Tobycsc/2dof-experiment-system/Readme.md

system-MainBoardv2

目前V2版本PCB使用的程序，芯片为STM32F407VET6，主要Task分别在对应.c文件内编写

gimbal.task为主任务，通信协议.docx中对其中变量定义与串口协议有详细说明，请不要参考论文最后的附录

论文描写内容绝大部分符合软件开发逻辑，有变化的部分主要为串口任务，目前串口处理逻辑为直接在uart_task内直接对gimbal_ctrl内变量进行更改，并调用写入flash，pid初始化等函数

### 目前问题

#### 电源拓补问题

电池单独供电时电机启动抽载过大导致母线电压降低，MCU因电压过低重启

1.线损过大 需重新设计接口或直接焊线（pcb线损待测）

2.母线并大电容

3.重做供电拓补 更换电源管理芯片 更换母线电压

4.更换电池类型，如动力锂电池/高能锂电池

#### 控制效果问题

单环PID控制效果不好

已写好双环PID所需框架，需后续调参
