Tobycsc/2dof-experiment-system/南京航空航天大学毕业设计（论文）.pdf

编号 182110424

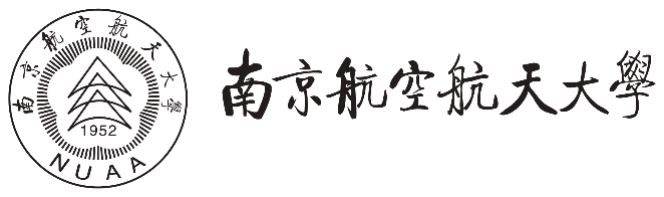
[picture p1: figure]

# 本科毕业设计（论文）

题 目

# 二自由度飞行姿态试验平台设计与

控制

学生姓名 | 于文俊
学 | 号 | 182110424
学 | 院 | 能源与动力学院
专 | 业 | 飞行器动力工程
班 | 级 | 0221104
指导教师 | 黄向华教授

### 二〇二五年六月

### 南京航空航天大学

### 本科毕业设计（论文）诚信承诺书

本人郑重声明：所呈交的毕业设计（论文）是本人在导师的指导下独立进行研究所取

得的成果。论文核心内容（如研究设计、数据分析、结论等）均为原创，未使用 AI 进行数

据篡改与虚构、规避查重等违规操作。尽我所知，除了文中特别加以标注和致谢的内容外，

本设计（论文）不包含任何其他个人或集体已经发表或撰写的成果作品。对本设计（论文）

所涉及的研究工作作出贡献的其他个人和集体，均已在文中以明确方式标明。

作者签名：

日 期： 2025 年 5 月 25 日

### 南京航空航天大学

### 毕业设计（论文）使用授权声明

本人完全了解南京航空航天大学有关收集、保留和使用本人所送交的毕业设计（论文）

的规定，即：本科生在校攻读学位期间毕业设计（论文）工作的知识产权单位属南京航空

航天大学。学校有权保留并向国家有关部门或机构送交毕业设计（论文）的复印件和电子

版，允许论文被查阅和借阅，可以公布论文的全部或部分内容，可以采用影印、缩印或扫

描等复制手段保存、汇编论文。保密的论文在解密后适用本声明。

论文涉密情况：

不保密 保密

保密期（起讫日期： 至 ）

作者签名： | 导师签名：
日 | 期： 2025 年 5 月 25 日 | 日 | 期： 2025 年 5 月 28 日

摘 要

二自由度飞行姿态实验平台作为《自动控制原理》等课程的实践载体，其教学价值日

益凸显，通过实体平台的操作，学生能够直观理解系统建模、控制器设计、稳定性分析等

关键知识点，并验证 PID 算法、频域响应等理论的实际效果。

目前各高校在本科教育流程中，缺少可靠有效的二自由度飞行姿态实验平台开展实践

教学。南京航空航天大学的李明洲、黄向华、张天宏于 2021 年申请了一种轻便的二自由度

飞行姿态控制实验台专利，在实践过程中发现一些问题导致该设计不能被广泛应用。本文

在其专利基础上进行修改与再设计，在实现功能的基础上增加其稳定性、安全性与可量产

性。

本设计中，结构上参考原专利的二自由度设计，同时调整 roll 轴轴线位置以更好的模

拟多旋翼飞行器的飞行状态。PCB 设计上保留原试验台的集成设计，使整个装置更为轻巧

便携。软件上部署 FreeRTOS 操作系统，保证姿态解算，控制与转发的实时性，最大程度

上提高控制效果。使用外部控制与自主控制两种模式，满足多种场景的需求。自主控制模

式中使用 PID 控制器进行姿态控制，通过简单的调参可实现最基础的姿态稳定。

通过多次迭代，已经实现预定的基础功能，自主控制效果较为理想，且外部控制功能

正常。

关键词：飞行姿态实验平台，专利产品化，PCB 设计，嵌入式开发，PID 控制器，上位

机通信

i

ABSTRACT

The two-degree-of-freedom (2-DOF) flight attitude experimental platform, as a practical

teaching tool for courses such as Automatic Control Principles, has demonstrated increasing

educational value. Through hands-on operation of the physical platform, students can intuitively

grasp key concepts including system modeling, controller design, and stability analysis, while

validating the practical effectiveness of theories like PID algorithms and frequency-domain

responses.

Currently, universities lack reliable and efficient 2-DOF flight attitude experimental platforms

for practical education. Li Mingzhou, Huang Xianghua, and Zhang Tianhong from Nanjing

University of Aeronautics and Astronautics patented a lightweight 2-DOF flight attitude control

experimental platform in 2021. However, issues identified during implementation hindered its

widespread adoption. This study modifies and redesigns their patented solution, enhancing

stability, safety, and mass producibility while retaining core functionalities.

Structurally, the design adopts the original 2-DOF framework but adjusts the roll axis position

to better simulate the flight dynamics of multi-rotor aircraft. For PCB design, the integrated layout

of the original platform is preserved to ensure compactness and portability. Software-wise,

FreeRTOS is deployed to guarantee real-time performance in attitude calculation, control, and data

transmission, optimizing control efficacy. The platform supports both external and autonomous

control modes to accommodate diverse scenarios. In autonomous mode, a PID controller is

implemented for attitude stabilization, enabling basic stability through straightforward parameter

tuning.

After iterative refinements, the platform achieves its foundational objectives: autonomous

control delivers satisfactory performance, and external control functions operate reliably.

KEY WORDS: Flight attitude experimental platform, Patent commercialization, PCB design,

PID controller, Host computer communication

ii

目录

iii

南京航空航天大学本科毕业设计（论文）

### 第一章 绪论

1.1 背景和意义

1.1.1 自动控制实验教学设备

由被控制系统与可自定义参数的控制器组成的教学实验系统是自动控制原理教学与

飞行器控制研究的重要载体。通过实体平台的操作，学生可直观验证 PID 控制、状态反馈、

频域分析等核心理论，并实践参数整定、系统建模等技能。例如，通过调节 PID 参数观察

姿态响应，能够深化对伯德图、奈奎斯特稳定性判据的理解。

1.1.2 低空经济与其载体

随着无人机、垂直起降飞行器等技术的快速发展，对飞行控制系统的教学与科研需求

日益增长。近期国家正快速发展低空经济，以满足秩序维护、设施巡检、农业工作等多项

任务需求，而低空经济的基础即为多旋翼无人飞行器。通过惯性传感器，光流传感器与激

光测距传感器等多种数据的输入与融合，飞控算法可以计算出各动力电机的期望输出，使

飞行器在空间中的六个自由度稳定可控。多旋翼无人飞行器的控制为典型的多输入多输出

系统控制。

1.1.3 二自由度飞行姿态实验平台

通过资料查询与实地调查，发现传统教学实验设备通常难以满足此类系统的控制模拟

需求。目前教学常用的电气实验箱可以模拟多种控制场景，但仅有电压模拟量输出，不够

直观；而电机等实验设备仅支持单变量控制，难以体现多自由度耦合、非线性动力学等复

杂控制场景，导致学生难以深入理解多输入多输出系统特性。同时，传统教学实验设备大

多依赖校内实验室环境，需要多种设备协同工作，不方便带到课堂等其他环境进行演示或

进行自定义算法验证。

针对以上痛点，一种二自由度飞行姿态实验平台的概念被提出。通过简单的轴系组成

拥有俯仰与滚转两个自由度的系统，同时固定两个驱动螺旋桨的电机在集成了惯性姿态传

感器的 PCB 上，可实现对两个自由度的闭环控制。将姿态解算与控制算法部署在 PCB 上

的 MCU 内，能够通过独立的实验装置完成所有控制任务，并提供对外接口完成自定义的

其他功能，为航空航天领域培养具备复杂系统设计能力的人才提供支持。

第一章 绪论
1.2 国内外研究现状

国内高校及科研机构在飞行姿态实验平台的设计与应用方面，主要基于实验平台来验

证新型的控制算法，重点放在实验平台的动力学系统建模与实际控制效果验证，而非面向

本科生的实验教学。

哈尔滨工业大学汤文开发的高精度飞行模拟器基于欧拉-拉格朗日方程建立非线性动

力学模型，系统复杂度高；清华大学尹航等开发了一款可变负载的非线性飞行姿态模拟系

统。但上述两种系统都是模拟传统构型直升机的动力学特性，即主旋翼＋尾旋翼的设计，

与多旋翼飞行器的动力学特性和控制方法相差甚远。

中国民航大学孟忱等开发的飞机电传操纵及模拟加载系统实验台则基于真实飞机电

传控制系统开发，可以很好的还原电传飞机舵面的控制特性，并应用在实验教学中。但此

系统为还原真实飞机电传系统，作动器与传感器等体积较大，且要结合专用实验箱进行操

作，不便于在其他位置使用。

国外相关领域则有部分商业公司与高校团队进行产品开发，但相关产品基本针对大型

实验室，且售价较高。同样，此类产品大多被用于先进的控制算法验证，而非协助自动控

制原理的入门。

Feedback 公司、加拿大 Quanser 公司、捷克 Humusoft 公司都有生产此类仿真实验平台

且均为两个自由度的仿真模型，分别由两个电机来驱动两个螺旋桨，根据俯仰和航向这两

个常用方向设计模型。与国内开发的类似模型相同，同样不符合多旋翼飞行器的模拟需求。

高校已经把成熟的控制方法的应用在这些商品上，取得了良好研究成果。斯坦福大学

将模型预测控制（MPC）应用于教学平台，验证先进控制理论的实际效果；苏黎世联邦理

工学院（ETH Zurich）则基于强化学习实现自适应控制。慕尼黑工业大学的 FlyCrane 平台

采用四自由度设计，集成高度控制维度，配套 30 余个实验案例库，支持鲁棒控制与自适应

控制研究，但单套成本较高。

1.3 本文主要工作

与工业级试验平台或实验室专用的算法验证平台不同，面向本科教育的实验系统需兼

顾理论验证、操作安全性、成本可控性和教学直观性。同时为便于大规模铺开与应用，系

统需要有一定的可靠性、安全性与量产性。

本文针对当下研究情况与原专利存在的痛点，设计了一款高度集成化的二自由度飞行

姿态试验系统，并实际制作了样品验证了其有效性。

1.3.1 原专利存在的问题

原设计中使用外置试验箱完成传感器数据采集、控制算法执行、电动机驱动三项任务，

其与试验台主体间的连接需同时传输模拟信号与功率驱动电流，干扰较大。二自由度试验

平台对实时性与准确性要求较高，外置试验箱的控制效果并不理想。同时模拟信号需要专

用设备进行解算，不便于自定义开发相关控制算法，且不够便携。

原设计的 Roll 轴并未穿过前部结构重心，在 Roll 轴不为零时结构自身的重量会产生

一个回正力矩，导致整个系统的动力学特性与多旋翼飞行器不一致。

1.3.2 新设计主要创新点

实验装置主体部分布置了六轴惯性测量单元与微处理器，只需供电即可实现自身的姿

态解算。同时电机与驱动电路也集成在此部分，使用微处理器进行电机转速控制。将上述

模块全部布置在一块 PCB 上并安装在主体部分，同时设置数字通信接口，即可通过上位机

通信来满足自定义控制需求。

针对结构方面的问题，修改 Roll 轴位置，同时在 PCB 的安装位置使用槽孔，即可调

整主体部分重心，使其穿过 Roll 轴，能够更好地模拟多旋翼飞行器的动力学特性。

为满足便携需求，将系统供电部分也集成在内，配合锂电池与充电管理电路，可以实

现系统完全脱离其他设备独立运行。将 USB 充电与上位机通信集成在 TypeC 接口上进一

步提高系统集成度。

1.4 论文组织结构

本论文的组织结构如下：

第一章 阐明课题的研究背景，介绍课题的研究现状和来源，并概述论文的主要工作和

创新点。

第二章 阐述设计的整体思路，展示系统框图；

第三章 介绍设计的结构部分与硬件原理图、PCB 设计；

第四章 介绍设计的嵌入式软件部分与控制算法，展示 PID 控制器效果；

第五章 总结全文，对今后的研究做出总结和展望。

第二章 系统整体设计概览

### 第二章 系统整体设计概览

2.1 系统设计思路

二自由度飞行姿态试验平台的开发涉及多个技术栈，包括结构设计，电路设计，PCB

设计与嵌入式软件开发。本节将会针对系统的需求进行分析，并将其分解以逐个实现。

2.1.1 需求分析

（1） 特性仿真

作为模拟多旋翼飞行器控制的实验平台，需要尽可能的模拟其动力学特征，包括被控

制系统与作动器输出特性，以保证控制算法的正常执行。

（2） 控制性能

飞行器控制对实时性与准确性要求高，无论是哪种控制方法都需要传感器与执行机构

的性能满足要求。

（3） 交互性

作为实验教学设备，需要满足教学需求，包括但不限于能够实时调整参数并展示控制

效果，有控制量与被控制量的直观显示等功能。

（4） 安全性与可靠性

由于系统存在高速运转的部件，且其运行状态能够自定义，需考虑设置权限高的安全

保护逻辑防止系统本身或操作者受到伤害。同时自身也要保证能够在尽可能宽广的环境内

稳定运行。考虑到本科生实验环境的多种恶劣条件与不当操作，需要采取措施最大限度保

证系统与操作者的安全。

（5） 量产性与通用性

为保证能够大规模铺开使用，需考虑可生产性与成本因素，包括生产工艺，器件选型

等方面。同时尽可能满足多种实验需求，做到一套装置通过可调部分完成各项不同的功能。

2.1.2 需求分解与实现

（1） 结构

参考原设计的轴系实现俯仰与滚转两个自由度的运动，同时修改轴系位置以模拟真实

飞行器的动力学特性。滚转轴放在俯仰轴上的设计可以使俯仰轴的控制模拟飞行器的高度

控制逻辑，并与滚转轴耦合，相当于减少了自由度的多旋翼飞行器。

结构材料使用 3D 打印件，降低研发成本，同时以板材设计逻辑进行建模，若有量产

需求可转为板材以大批量生产。提前考虑装配工艺设计，保证量产性。

将 PCB 板作为主体结构的一部分，同时各安装孔位使用阵列孔与槽孔，通过调整安装

位置以调整重心，实现对系统特性的调节以匹配多种实验需求。

为保证安全，预留保护罩设计或使用轻巧的旋转部分。

（2） 硬件

硬件作为软件与结构间的桥梁，需要提供稳定的软件运行环境，同时配合结构设计组

成系统主体部分。PCB 设计时元件的布置尽量重量上对称，便于重心调整。

电路设计保证可靠性，对外接口与电源网络预留保护电路，针对反接过流等特殊情况

增加保护元件。

由于同时存在电机等功率器件与锂电池供电，电源网络需提前设计，将功率电源网络

与数字电源网络进行分割以降低互相影响。

电路板设计时需初步考虑功耗、底噪、发热、电磁干扰等问题，同时尽可能选用成本

低供应稳定的物料，为后续产品化做最基本的准备。

（3） 软件

飞行器控制对实时性与准确性要求高，需要针对此做特别的优化，如系统性能，传感

器数据处理等。通过部署操作系统与 AHRS 算法可以实现媲美飞控的控制效果。

软件需配合硬件设计保护策略，在系统工作不正常或者输入不符合要求时，能够防止

系统对操作者或自身造成伤害。

系统部分参数需对外开放，软件上需要有接口能够进行调整，同时系统整体运行也需

上位机进行控制。

2.2 系统框图

2.2.1 已完成部分框图

图 2.1 为系统总体框图，由图可知，系统主体 PCB 集成了所需的功能模块，包括锂电

池充放电管理模块、传感器模块、电机及其驱动模块与 MCU，同时外接 1S 锂电池，并预

留多个对外通信接口。

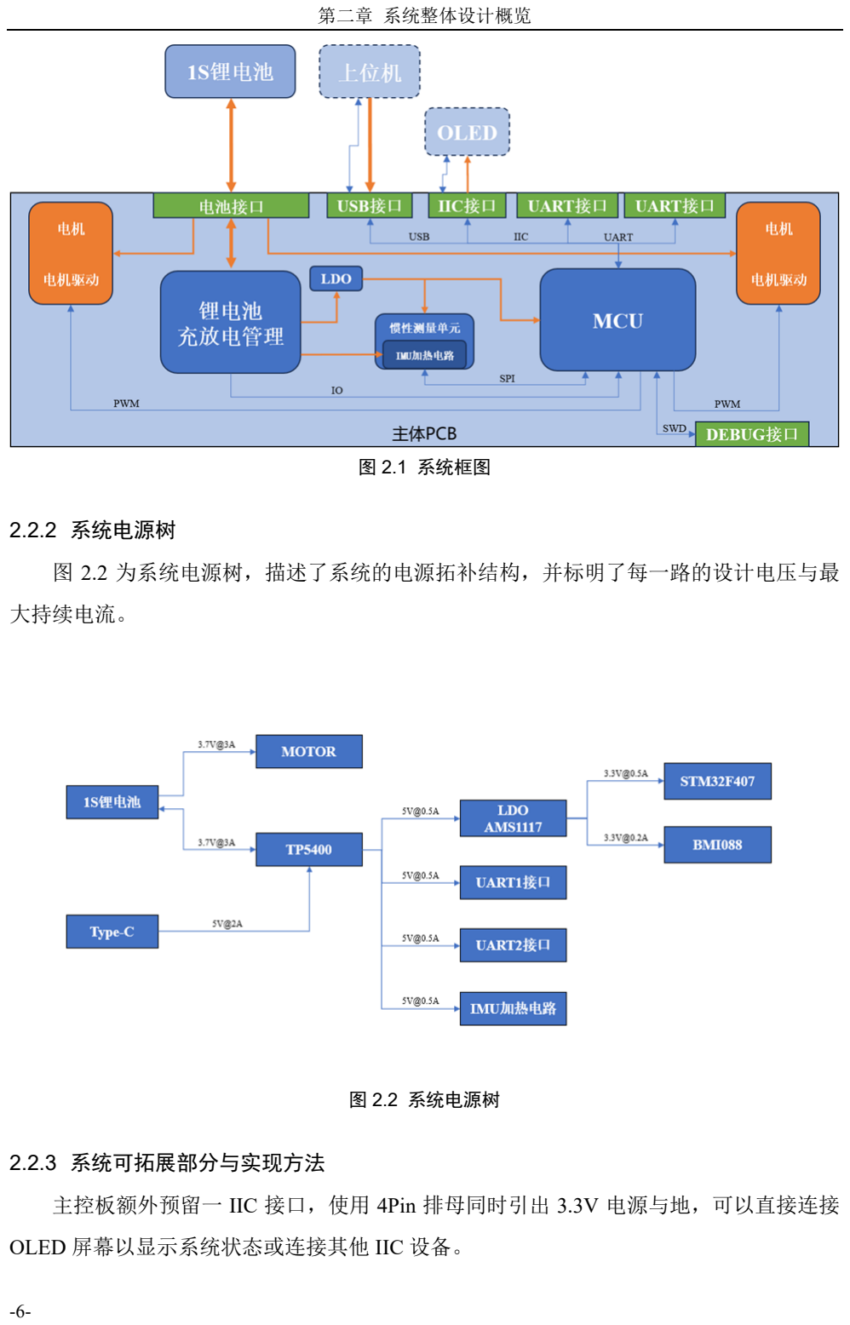
[picture p2: page 14]

第二章 系统整体设计概览

图 2.1 系统框图

2.2.2 系统电源树

图 2.2 为系统电源树，描述了系统的电源拓补结构，并标明了每一路的设计电压与最

大持续电流。

图 2.2 系统电源树

2.2.3 系统可拓展部分与实现方法

主控板额外预留一 IIC 接口，使用 4Pin 排母同时引出 3.3V 电源与地，可以直接连接

OLED 屏幕以显示系统状态或连接其他 IIC 设备。

同时预留两个 UART 接口，使用 4Pin 连接器引出 5V 电源与地，可以连接其他模块与

主体部分进行通信，通过二次开发可实现更多的拓展功能。

2.3 本章小结

本章主要阐述设计的整体思路，完成了产品的需求分析与分解，并分别提出结构硬件

与软件的设计点以满足需求。同时绘制设计的系统框图与电源树，明确设计的系统架构与

电源网络，为后续展开说明各部分做准备。

第三章 结构与硬件部分

### 第三章 结构与硬件部分

3.1 结构设计

3.1.1 结构设计概览

本实验装置主要目的为模拟四旋翼飞行器的工作状态并对其进行控制。故首先分析四

旋翼飞行器静止时的动力学特性。由于机身静止，同时忽略姿态调整时产生的空气阻力，

故整机只受重力影响。根据上述分析，需要一个恒定向上的力来平衡重力，此时机身在空

中静止，而不同位置电机出力不同会产生翻滚力矩，改变飞机的姿态。综上，各电机的出

力竖直方向向上的合力用于控制飞行器的高度，不同电机出力差值产生的力矩用于控制飞

行器姿态。

由于忽略空气阻力，飞行器姿态调整时不会产生额外阻力，故 Pitch 轴与 Roll 轴使用

塞打螺栓与轴承配合，减少轴系产生的摩擦力。Pitch 轴一侧预留配重安装位置，通过施加

不随角度变化的恒定载荷，可模拟飞行器自重产生的载荷。为方便加工与装配，同时可以

快速迭代，使用 3D 打印制作结构件。材料选用 PLA，兼顾结构强度与重量需求。同时 3D

打印件加工灵活，可以在轴系与螺丝孔等位置添加补强以弥补与板材的强度差距。

结构设计与 PCB 设计一同迭代。第一代结构件设计由于参考原专利，需要在 PCB 安

装时使用额外板材调整位置，使重心位于 roll 轴线上。由图可看出，这种安装方法引入了

多个没有约束的自由度，虽然方便调整重心，但是会导致系统动力学特征不稳定。第二代

设计了槽孔与多个可调安装孔，可以直接调整好角度安装 PCB，通过槽孔微调安装位置，

起到校准重心的作用。同时第二代设计减小了 pitch 轴与 roll 轴的大小，降低两轴的转动惯

量，使电机选型有更大的空间。

PCB 作为结构件的一部分，在原理图绘制之前就需要提前设计出板框与安装孔，导入

至建模软件进行预览。由于器件重量与焊接差异，PCB 的重心不好直接确定，故在上文结

构设计中引入可调结构。第一代电机布置在 PCB 上，使 PCB 重量较大，同时由于电机质

量较大且距离两轴位置较远，转动惯量显著增大。第二代将电机布置在结构件引出的悬臂

上，压缩 PCB 空间以减少重量，起到减小转动惯量便于控制的作用。图 3.1，3.2，3.3 分别

为两代设计的建模图与实物图。

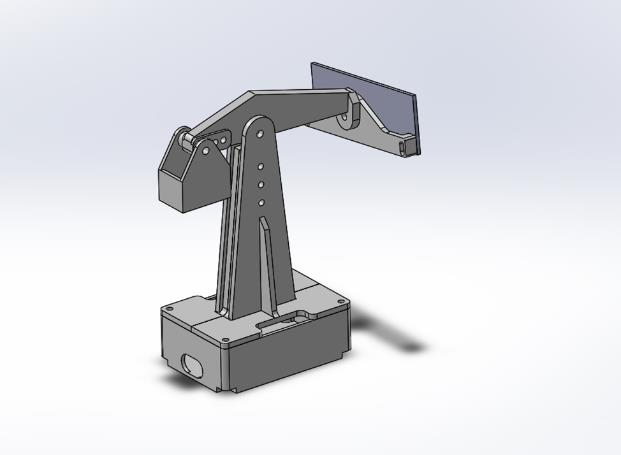
[picture p3: figure]
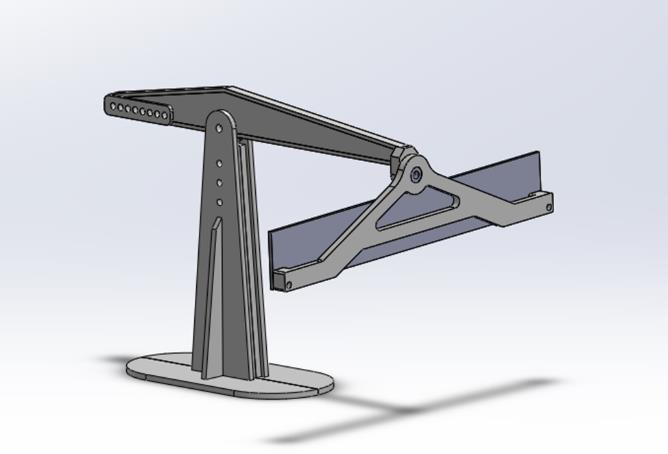
[picture p4: figure]

（a）第一代 | （b）第二代

图 3.1 结构三维建模图

3.1.2 结构实物展示

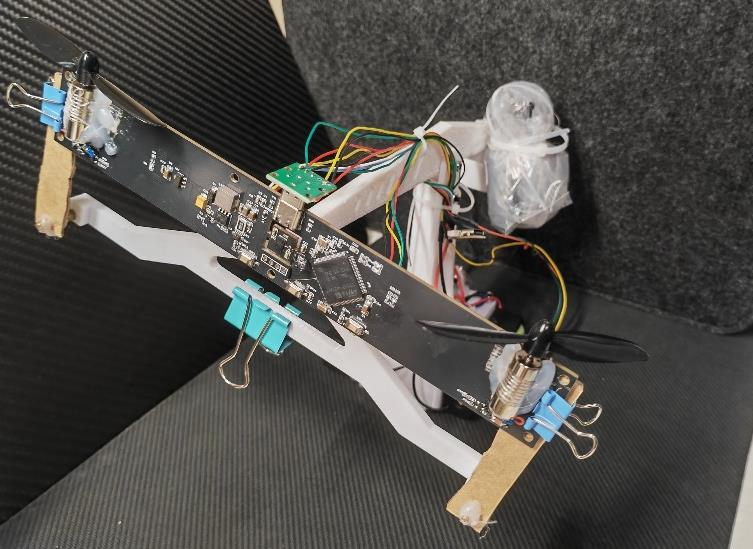
[picture p5: figure]

图 3.2 第一代实物全貌

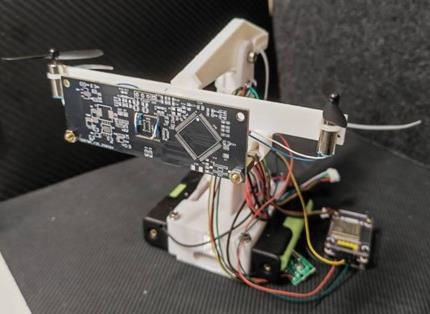
[picture p6: figure]

图 3.3 第二代实物全貌

第三章 结构与硬件部分
3.2 硬件设计

实验装置以安全为主，同时整个系统姿态控制负载不大，故使用空心杯电机，参照 710

空心杯电机参数，两个电机额定功率合计在 1w 以内。飞行器控制对控制频率要求较高，

主控选用 STM32F407VET6， IMU 选用 BMI088，通过 SPI 与主控通信。

STM32F407VET6 是意法半导体（STMicroelectronics）推出的一款高性能微控制器，

属于 STM32F4 系列，常用于性能要求高的场景，如飞控芯片。其内核为 32 位 ARM Cortex-

M4，支持浮点运算单元（FPU），在姿态解算等场景可显著提升计算效率。主频最高可达

168 MHz，计算性能达 210 DMIPS。其使用 1.8v-3.6v 供电，运行模式下典型功耗低至 238

µA/MHz，可节省实验装置供电所用电池的电量。其外设资源丰富，拥有多个 SPI、UART、

IIC、USB 等通信接口，可以与上位机或外设进行通信。同时拥有多通道 ADC 与多个独立

定时器，可完成采集电压温度等模拟量，输出 PWM 等工作。通过丰富的开发生态与集成

度高的开发环境，可以快速编写所需业务并进行调试。

BMI088 是博世（Bosch Sensortec）推出的一款高性能 6 轴惯性测量单元（IMU），集

成了三轴加速度计和三轴陀螺仪，专为高精度运动传感和动态控制场景设计。加速度计的

测量范围可以通过编程调整为±3g 至±24g，陀螺仪测量范围可以通过编程调整为±125dps

至±2000dps。加速度计与陀螺仪噪声水平低，分别为±3g 时噪声密度 120 µg/√Hz 与±125dps

时噪声密度 0.38 mdps/√Hz。同时加速度计与陀螺仪的精度极高，零偏稳定性分别为±30mg

与±10dps。其内置数字滤波器，且陀螺仪输出速率最高 2 kHz，加速度计输出速率最高 1.6

kHz，抗干扰能力强且姿态响应速度快。同时加速度计和陀螺仪支持时间戳同步，能够提升

数据融合精度。此传感器常用于无人机等高动态系统。

考虑到控制需求与交互模块的用电需求，USB2.0 的 2.5w 的最大输出功率不能保证系

统稳定。在主体部分设置两颗 18650 电池并联，配合电源管理电路作为整个系统的供电，

在接入外部电源时可给电池充电。电源芯片选用 TP5400，其为一款专为单节锂离子/锂聚

合物电池设计的集成电源管理芯片，集成了充电管理、升压输出和保护功能。整个系统额

定电源电压为 5v，同时 IMU 部分与控制部分有独立的 LDO 进行稳压。

主控预留 UART 与 IIC 通信接口，可使用 USB-TTL 连接上位机或直接连接交互模块，

同时可以连接 OLED 屏幕显示信息。主体同时使用 Type-c 接口，为电池进行充电，并可以

通过 USB 虚拟串口连接上位机，与使用 UART 接口效果相同。

3.2.1 原理图设计

（1） 电源部分

以 TP5400 与外围元件为核心，集成 5V 输入与电池接口。因 TP5400 集成度较高，外

围仅需布置少量的电阻电容与一个升降压电感即可工作。使用 AMS1117 为系统数字部分

提供 3.3V 供电，降低供电网络的纹波。AMS1117 是一款低压差线性稳压器（LDO），广泛

应用于电子电路中的电压稳压场景。其核心功能是将输入电压（如 5V、12V）转换为稳定

的低压输出（如 3.3V、5V 或可调电压），同时具备低功耗、高精度的特性。由于电池没有

频繁插拔需求，同时接口自带防呆设计，故只增加 ESD 防护，不设置缓起动与防反接电路。

图 3.4 为电源部分原理图。

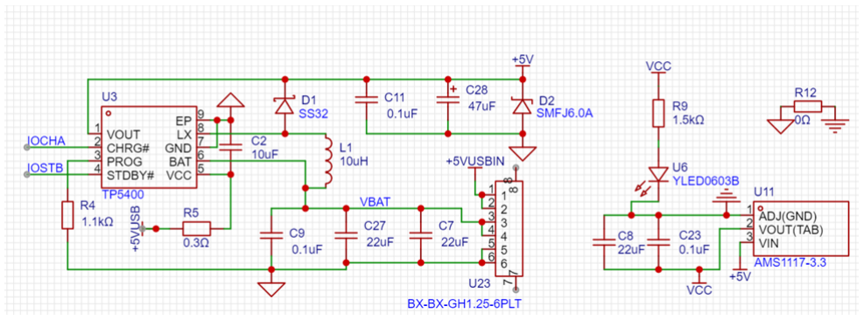
[picture p7: figure]

图 3.4 电源部分原理图

（2） 主控部分

主要以芯片为核心部署必要的外围电路，包括时钟与复位电路、电压采样电路等，同

时引出用到的 IO 口。由于 STM32 内部振荡器精度较低，而飞控对控制频率与传感器读取

的时间精度要求较高，故使用外部振荡器，根据手册配置起振电阻与匹配电容。复位电路

布置 RC 上拉电路，保证复位引脚平稳上电且电平稳定，同时设置下拉复位按键。为读取

锂电池电压，使用电阻分压电路将电池电压引入 ADC 引脚。图 3.5 为主控部分原理图。

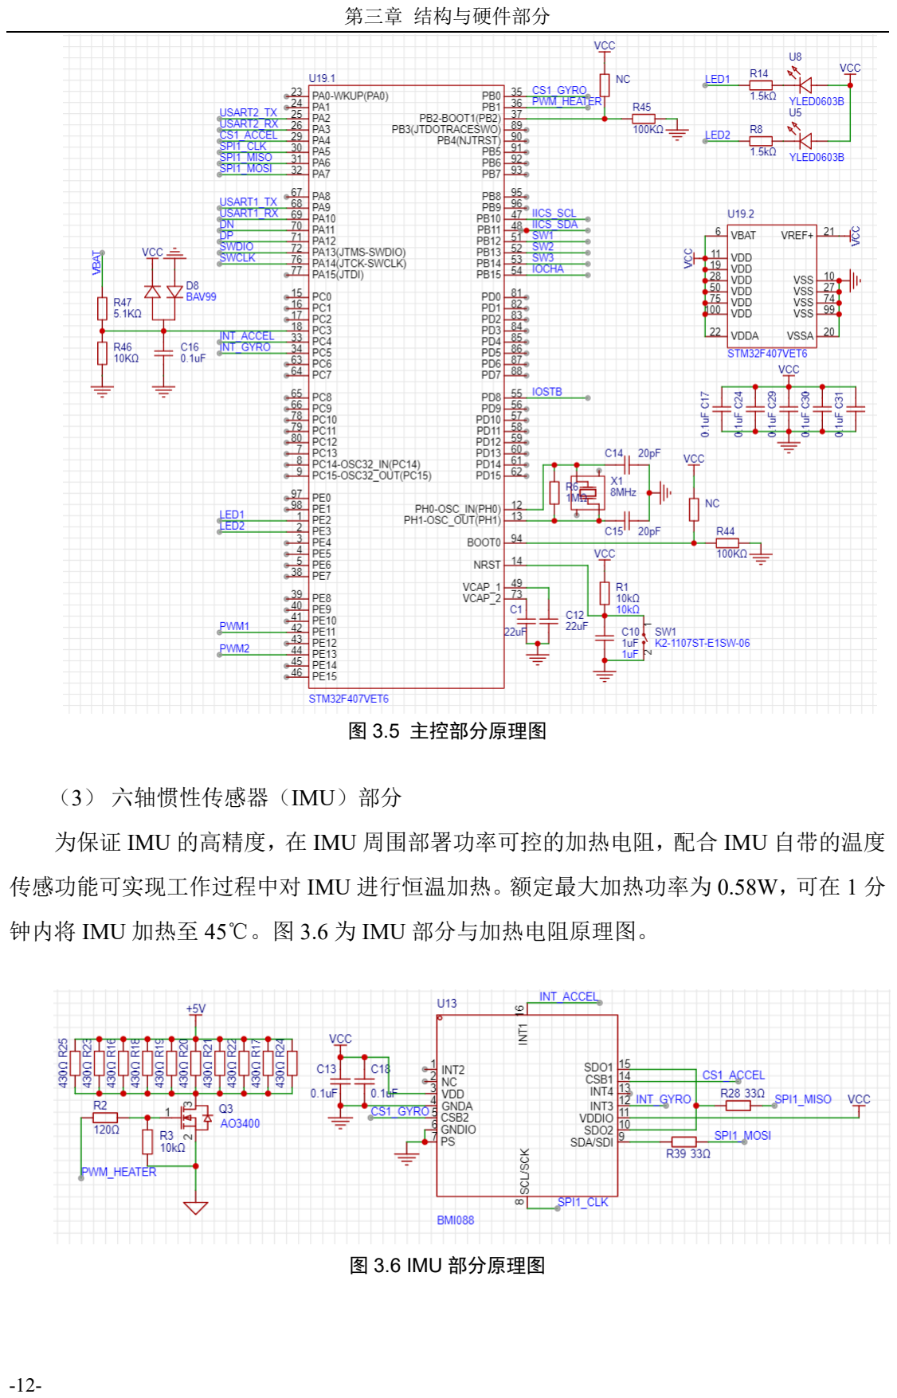
[picture p8: page 20]

第三章 结构与硬件部分

图 3.5 主控部分原理图

（3） 六轴惯性传感器（IMU）部分

为保证 IMU 的高精度，在 IMU 周围部署功率可控的加热电阻，配合 IMU 自带的温度

传感功能可实现工作过程中对 IMU 进行恒温加热。额定最大加热功率为 0.58W，可在 1 分

钟内将 IMU 加热至 45℃。图 3.6 为 IMU 部分与加热电阻原理图。

图 3.6 IMU 部分原理图

（4） 电机驱动部分

空心杯电机使用电池直供供电，为便于驱动，使用 NMOS 低侧驱动。通过前文分析与

方案验证时实测，电机功率较小，使用 AO3400 可满足需求。AO3400 是一款由 Alpha and

Omega Semiconductor（AOS）公司设计的 N 沟道低压 MOSFET，凭借其低导通电阻、高

电流能力和紧凑封装，广泛应用于电源管理、负载开关及高频开关场景。VGS=2.5V 时，

导通电阻 Rdson<52mΩ，低压驱动时损耗较小。且栅极电荷 Qg 仅为 8.3nC，使得该 MOS

可使用单片机 IO 口直接驱动，省去驱动电路的设计。图 3.7 为电机驱动部分与电机部分原

理图。

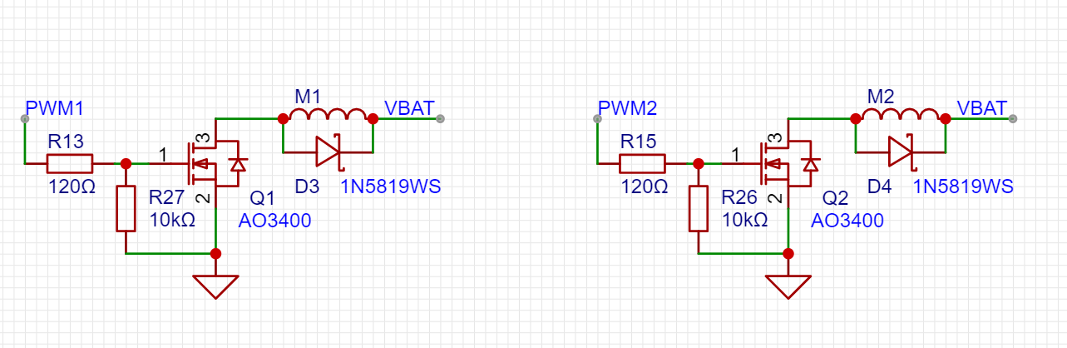
[picture p9: figure]

图 3.7 电机驱动部分原理图

（5） 接口部分

主要对外接口为 USB 接口、UART 接口、IIC 接口。在这些接口处添加保护器件，以

应对频繁插拔的工况。主要为解决 ESD 问题与 EMC 问题。

ESD（Electrostatic Discharge）是静电电荷瞬间释放的现象，可能导致电子元件击穿或

功能异常，常见于人体接触、设备操作或环境摩擦场景。可能会导致 IC 芯片、MOS 管因

高电压脉冲烧毁；或者 ESD 电流通过信号线或电源线耦合，导致逻辑错误或复位。同时轻

微的 ESD 损伤可能短期内未显现，但长期会降低器件的可靠性。

EMC（Electromagnetic Compatibility）要求设备自身不产生超标电磁干扰（EMI），同

时能抵抗外部干扰正常运作，是产品通过认证（如 FCC、CE）的核心指标。PCB 设计中

EMC 问题主要包括高频信号线（时钟、开关电源）成为天线，向外辐射噪声；噪声通过电

源或信号线耦合到其他电路或外部设备；外部电磁场（如手机射频）引发电路误动作。

使用防 ESD 二极管导通高压电流，主要为人体接触产生的静电。信号线添加上拉电阻

保证空闲状态时信号线电平的稳定。靠近接口处布置串阻磁珠，防止自身通信时产生的电

磁干扰辐射到外界。

第三章 结构与硬件部分
DEBUG 接口为单片机调试与二次开发使用。同时各接口提供电源与地，便于外设使

用。由于机械按键在按下或释放时，由于金属触点弹性形变，会产生短暂的电平抖动，导

致信号被误判为多次触发。将单片机使用的按键引出至外置小板并加入硬件防抖电路，确

保每次按键动作仅触发一次有效信号，降低软件负担，并能够避免在运动的主体上使用按

键。图 3.8 为接口部分原理图。

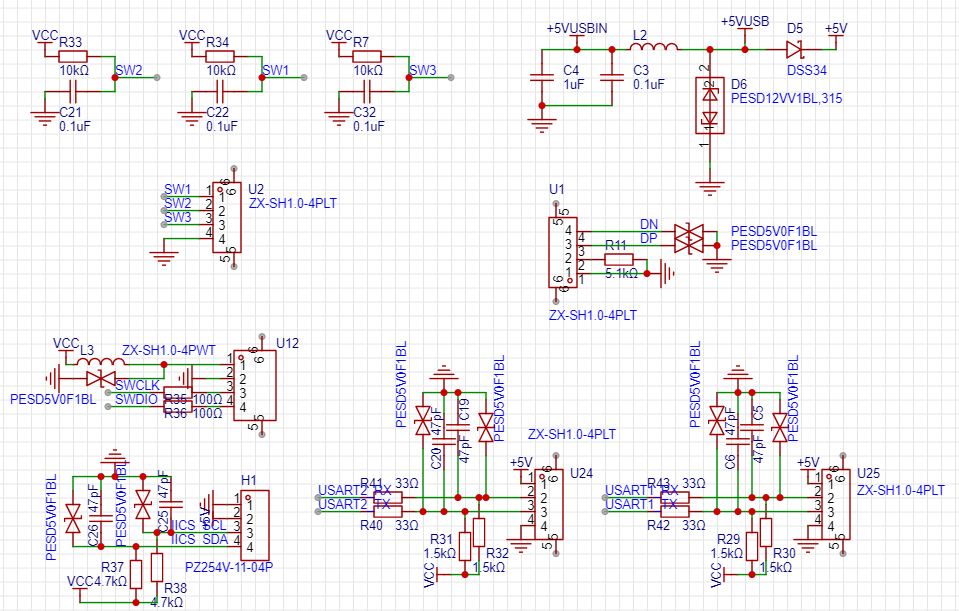
[picture p10: figure]

图 3.8 接口部分原理图

3.2.2 PCB 设计

PCB 在结构设计的过程中已经给出了板框与安装孔的约束，此部分工作主要为根据原

理图进行 Layout，并合理安置对外接口的位置防止干涉。

Layout 时为避免底噪和 EMC 问题，将功率地与模拟地分开并使用单点接地，在开关

电源等位置保证地平面完整；MCU 与 IMU 电源引脚附近布置旁路电容，供电芯片输出端

布置去耦电容。在两个电源芯片附近使用大面积铺铜帮助散热，同时使用内层铺铜协助热

量快速扩散。因为 IMU 部分有恒温加热，工作温度较高，故通过开槽的方式将 IMU 与 PCB

主体分离开。

第一代 PCB 由于需要安装电机，两侧扩展较大，元件布置空间较大。但 IMU 开槽挤

占走线空间，而互联较多的 MCU 位于右侧，导致左右连线较困难。接口统一布置在下侧，

实际组装时连线左右跨度较大，会干涉 Roll 轴旋转。第二代 PCB 整体空间被压缩，但实

际面积仍足够布下所有元件。实测开槽尺寸数据与实际影响，将槽宽减小至 1mm，为走线

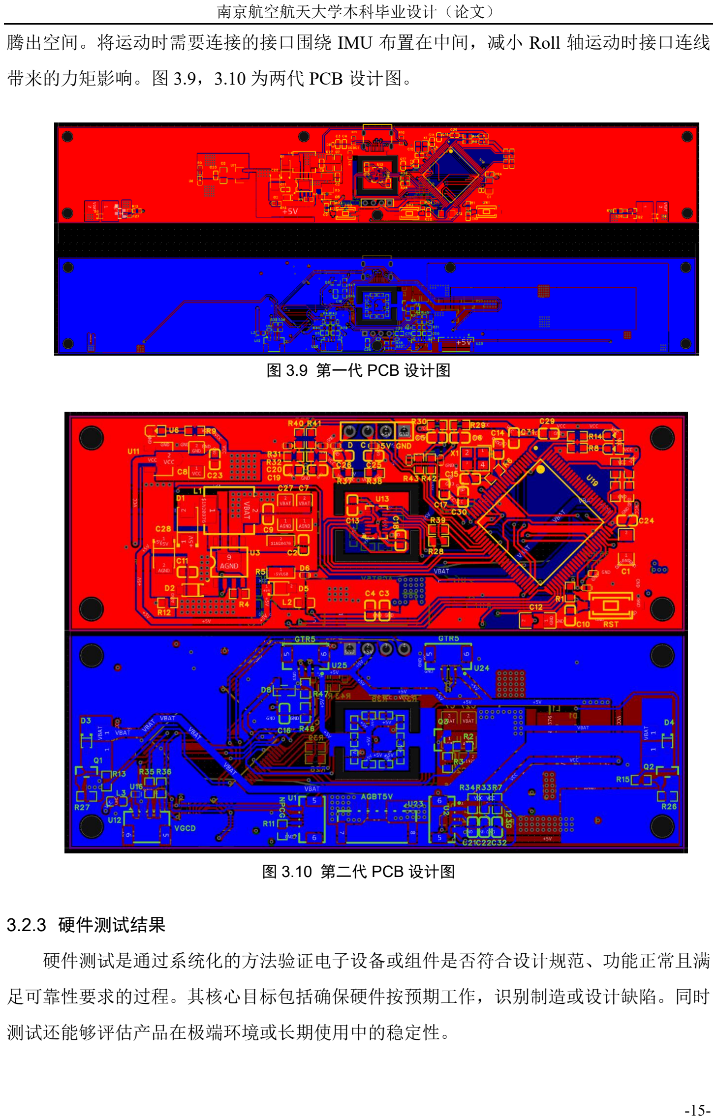
[picture p11: page 23]

腾出空间。将运动时需要连接的接口围绕 IMU 布置在中间，减小 Roll 轴运动时接口连线

带来的力矩影响。图 3.9，3.10 为两代 PCB 设计图。

图 3.9 第一代 PCB 设计图

图 3.10 第二代 PCB 设计图

3.2.3 硬件测试结果

硬件测试是通过系统化的方法验证电子设备或组件是否符合设计规范、功能正常且满

足可靠性要求的过程。其核心目标包括确保硬件按预期工作，识别制造或设计缺陷。同时

测试还能够评估产品在极端环境或长期使用中的稳定性。

第三章 结构与硬件部分
系统的 5V 电源网络与 3.3V 电源网络在工作时需保持稳定，故通过测试纹波率描述其

电压稳定性。为保证传感器数据的可靠性与上位机通信的可靠性，需测试 SPI 与 UART 的

通信稳定性。电机工作时会对电源网络产生较大影响，故测量最大工作时的电流，判断其

是否超过电源放电能力。在正常工作状态下测试多种工况的硬件性能，并取最差值，全部

满足要求。

纹波测试在示波器上进行，使用 200M 探头，交流耦合档，带宽限制 20M，并开启余

晖模式采集一分钟。由于软件调试过程中通信正常，故不检测信号质量，而通信协议丢包

率与 IMU 更新频率由特定脚本的软件采集得到。电机满载电流由电源代替电池供电并直

接测出。表 3.1 为整理后的测试结果。

表 3.1 硬件测试数据
测试项目 | 参考值 | 实际值
3.3V 电源纹波率 | <2% | 1.1%
5V 电源纹波率 | <5% | 3.4%
UART 通信丢包率 | <0.1% | 测试过程未出现
SPI 通信丢包率 | <0.1% | 测试过程未出现
IMU 数据更新频率 | 1kHz | 1kHz
电机满载电流 | <3A | 2.1A
3.3 本章小结

本章主要梳理了结构与硬件部分的设计思路，详细阐述了结构与硬件设计如何满足前

文提出的需求。结构部分主要分析了其如何满足四旋翼飞行器动力学仿真的需求，同时介

绍了其生产工艺方面的设计。硬件部分主要介绍了原理图设计与 PCB 设计如何在满足功能

要求的基础上兼顾安全保护与生产。同时记录了设计的迭代过程，分析了第一代结构硬件

设计中存在的问题并在第二代设计中引入了改进措施，使设计趋于完善。

### 第四章 软件部分

4.1 软件设计概览

主体部分的 MCU 负责整个系统的运行控制，通过对 MCU 的主程序进行编写可以实

现系统的所有功能需求。为保证系统的实时性，部署 FreeRTOS 操作系统来完成各个任务。

FreeRTOS 是一款开源的实时操作系统（RTOS），专为嵌入式微控制器设计，广泛应用

于资源受限的物联网（IoT）、工业控制、消费电子等领域。其核心是为多任务处理提供高

效、可靠的调度框架。其核心功能与特点为支持抢占式、协作式和时间片轮转调度策略，

通过优先级机制确保关键任务（如传感器数据采集、控制指令）的实时响应。同时其内核

代码精简（通常仅占用 6-15KB ROM），模块化设计允许开发者按需裁剪功能，适配低内存

（如 ARM Cortex-M、ESP32 等）的微控制器。并且 FreeRTOS 提供任务间通信工具（队

列、信号量、互斥锁）、动态内存分配（堆管理）和软件定时器，能够确保资源共享的安全

性与效率。

目前编写的任务有主任务，姿态解算任务与串口任务。主任务负责处理整个系统的运

行，姿态解算任务负责读取 IMU 的数据并进行姿态解算，串口任务负责与上位机进行通

信。

系统有多种控制模式，可通过上位机或按键进行控制模式的选择。模式一：自主控制

模式。通过通信接口输入期望的两个自由度的位置，控制器读取 IMU 数据在内部进行 PID

计算并输出 PWM 量对电机进行控制。同时可通过通信接口输入指令，实时对 PID 参数进

行调整。模式二：转发模式。MCU 读取 IMU 信息，根据通信协议从通信接口转发出去。

并根据协议接收输入的两个 PWM 值直接输出 pwm 量对电机进行控制，PID 或其他控制算

法的计算在计算机上完成。

4.1.1 主任务逻辑

主任务命名为 Gimbal_Task，主要执行系统主逻辑控制任务、姿态获取任务与自主控

制模式下 PID 计算任务。图 4.1 为主任务执行的流程图。

系统上电后先进行初始化，读取闪存中存储的系统参数并准备运行。由于系统大部分

参数支持断电后保存，需要存入专用的闪存空间，故每次上电都需要从这些空间进行参数

读取。初始化后进入大循环开始执行主任务。首先进行数据更新，读取 INS_Task 中经过处

理的传感器数据，即姿态解算后的各自由度角度，与上位机或自身按键输入的控制数据，

第四章 软件部分
并对各变量进行赋值。之后判断目前的工作模式，不同工作模式有不同的工作策略。若为

自主控制模式，则将两个自由度的期望值与实际值送入 PID 计算，并进行动力解算，得到

两个电机的输出；若为外部控制模式则直接读取上位机发送的各电机期望输出。在电机控

制函数中进行判断，若电机目前为使能状态，则将得到的电机期望值赋值给定时器，通过

GPIO 输出对应占空比的 PWM；反之将定时器占空比清零，输出持续的低电平。定时器输

出的 PWM 信号分别连接至对应电机的控制 MOS 管，PWM 占空比则对应 MOS 管的开通

时间，故改变占空比即可改变电机的功率。最后将设置为输出的数据进行串口发送，完成

一次完整的控制流程。大循环执行频率为 200Hz，目前每执行 200 次主任务大循环会翻转

一次 LED1 的 GPIO，故系统正常工作时 LED 会以 0.5HZ 进行闪烁，可以此判断系统目前

的工作状态。

同时为保护使用者的安全，主任务有一系列软件保护措施。在两种模式下的 PWM 输

出值都会被限幅至定时器支持的范围，防止向寄存器中写入错误的数据。所有输入的控制

量与参数都会经过有效性校验，若上位机输入过大或过小，系统会判断上位机失能，自动

失能两个电机。在外部控制模式下若持续 3 秒未收到上位机数据也会自动失能电机。

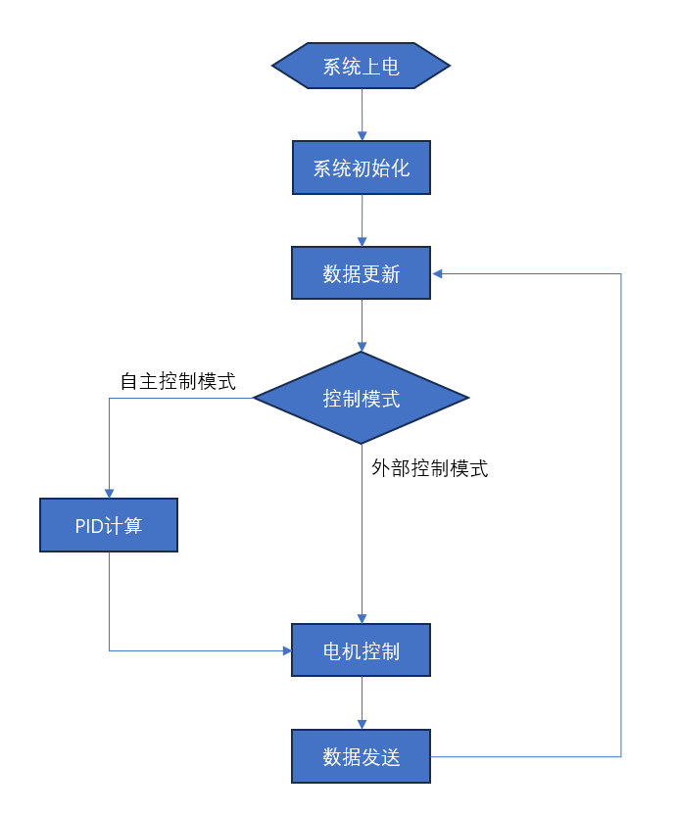
[picture p12: figure]

图 4.1 主任务执行流程图

4.1.2 姿态解算任务逻辑

姿态解算任务命名为 INS_Task，主要进行与 IMU 的通信与姿态解算，同时负责 IMU

的恒温加热控制。图 4.2 为姿态解算任务执行的流程图。

系统上电后先进行初始化，主要为 SPI 与 DMA 的相关配置，会根据 BMI088 的器件

手册配置 SPI 通信的速率，时钟信号等参数，并配置 DMA 接收以节省 MCU 的 CPU 资源。

通信初始化完成后对 BMI088 的寄存器进行配置，主要包括配置角速度和加速度的更新方

式，更新速率和中断输出引脚等。初始化后进入大循环开始等待外部触发。在初始化中，

配置 BMI088 以最高频率进行数据输出，并在每次数据更新时通过外部引脚产生中断信号。

在中断回调函数中对外部中断进行处理，每次中断产生时开启 SPI 通信读取对应的数据并

通过 DMA 存至缓冲区。若加速度计、角速度计、温度数据都进行了一次中断触发，则发

送信号量至 INS_Task。INS_Task 接收信号量后开始执行，读取 DMA 缓冲区中 BMI088 的

原始数据，对姿态数据的四元数进行姿态解算输出三轴角度，其中姿态解算的过程会在后

文详细介绍。将温度数据与设定温度送至 PID 计算，输出值作为 PWM 占空比送入定时器

输出 PWM 信号，控制加热电阻的 MOS，实现对 IMU 加热功率的闭环控制。最后将 Pitch

与 Roll 的实际角度数据存储至对外数组供主任务读取，重新进入等待状态，完成一次完整

的姿态解算流程。传感器任务执行频率为 IMU 中断产生频率，正常情况下为 1kHz。

第四章 软件部分

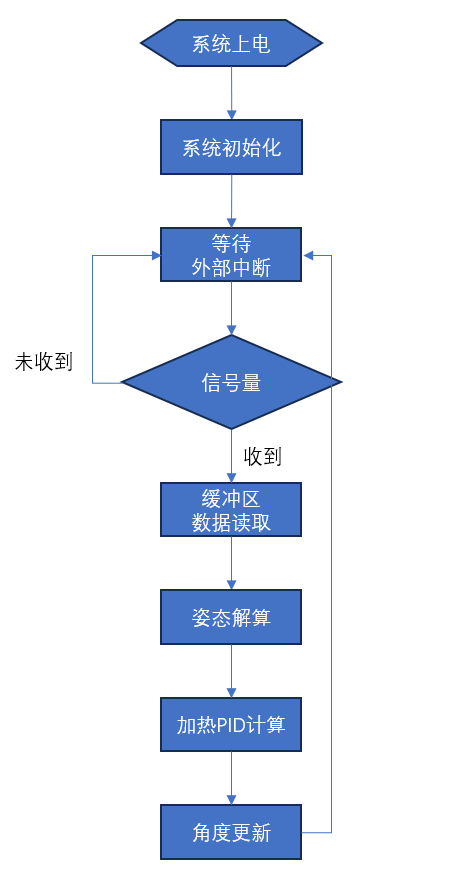
[picture p13: figure]

图 4.2 姿态解算任务执行流程图

4.1.3 串口任务逻辑

串口任务命名为 INS_Task，主要进行串口通信，接受并处理上位机发送的控制数据。

同时也负责后续会增加的 OLED 屏显示通信功能。图 4.3 为串口任务执行的流程图。

系统上电后先进行初始化，主要为串口 DMA 的相关配置，通信初始化完成后进入大

循环开始等待数据接收。串口使用的波特率为 115200，同时没有校验位与流控，故理想情

况下每秒能传输 11520 个字节。以主程序运行频率进行发送时每次可发送 50 个字节，正常

工作通信时带宽占用较低，故普通串口使用空闲中断进行数据接收触发，每次产生空闲终

端时将数据存入缓冲区并产生数据接收信号。USB 串口单次接收 64 字节以内的数据时会

进入一次回调函数，故在此函数内将数据存入缓冲区，同时产生数据接收标识。大循环中

检测到数据接收信号后，会首先判断数据包的帧头帧尾，并送入相应的函数进行处理。处

理后将数据打包至串口结构体并更新串口接收标识，等待主函数处理，并重新进入等待状

态，完成一次完整的串口接收流程。传感器任务执行频率为串口接收频率，取决于上位机

的工作状态。

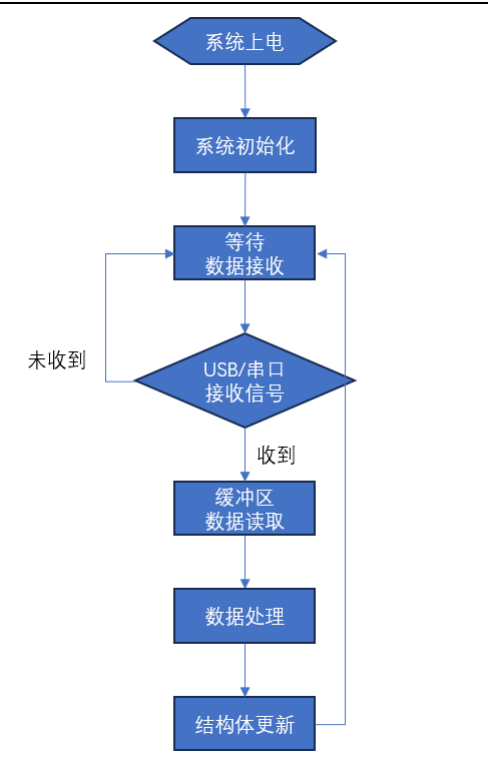
[picture p14: figure]

图 4.3 姿态解算任务执行流程图

4.1.4 对外接口设计

系统主要控制方法为通过上位机按照通信协议发送数据。其基本支持对系统全参数的

修改与实时反馈，具体通信协议见附录。控制指令包括修改基本运行状态指令，修改 PID

参数指令，保存修改内容指令与外部控制指令。系统同样会向上位机发送数据，此功能可

通过控制指令调整工作状态，具体见下文。

通过修改基本运行状态指令，可以控制系统的基本设定。包括系统工作模式，电机使

能状态与参数实时反馈开关。其中参数实时反馈支持系统基本设定值、试验台姿态值与 PID

参数的实时反馈，试验台姿态值默认在电机使能状态下以 200Hz 输出，其他两个参数开启

后会以 5Hz 的频率输出，便于进行实时上位机软件开发。

通过修改 PID 参数指令，可以调节自主控制模式下两个轴的 PID 参数，包括 PID 模

式、PID 限幅、PID 积分限幅、PID 各项系数。为保证系统安全运行，修改 PID 参数指令

只在电机失能状态下有效。

通过保存修改内容指令，可将上述除电机使能状态可更改的参数存储至系统闪存，下

电后参数不会消失，下次上电可继续使用。为安全考虑，每次上电时电机都是失能状态。

外部控制指令在外部控制模式下生效，包括两个电机的输出期望值，会被直接送入定

时器进行电机控制。

第四章 软件部分
为方便无上位机的情况下进行基本操作，可通过外置按键进行基本控制，目前 SW1 为

使能状态切换，另外两个按键预留为后续开发使用。

4.2 控制算法设计

系统主要包括姿态解算算法与 PID 控制算法，其中姿态解算算法为两个模式通用，PID

控制算法在自主控制模式下启用。

4.2.1 姿态解算算法

AHRS（Attitude and Heading Reference System）俗称航姿参考系统，AHRS 由加速度

计，磁场计，陀螺仪构成，能够为飞行器提供航向(yaw)，横滚(roll)和侧翻(pitch)信息，这

类系统用来为飞行器提供准确可靠的姿态与航行信息。航向角通过融合地磁场数据实现，

确保在无 GPS 环境下仍能提供绝对方向参考。同时可检测载体的加速度、角速度及线性运

动状态，用于分析载体的动态行为（如振动、冲击），适用于飞行控制、船舶稳定等场景。

常用的 AHRS 系统内置校准功能（如陀螺零偏校正、磁力计软硬铁补偿）和温度补偿，确

保传感器数据长期稳定性，减少环境干扰影响。

系统主要依靠 Pitch 轴与 Roll 轴的角度相关数据运行，同时单次运行时间较短，对漂

移不敏感，故使用单 IMU 角速度数据积分的方式读取角度，同时借助三轴加速度进行校

准。由于本系统自由度较少，无航向角的数据需求，可以不使用磁力计来获取地磁场数据。

系统 MCU 内置由大疆创新开发的闭源 AHRS 算法，配合 BMI088 的数据可以实现极好的

姿态解算效果。由于此算法具体实现无法公开，故简单介绍不使用磁力计校准的简单 AHRS

系统工作流程。

通过 SPI 读取的 BMI088 数据为三轴角加速度值与线加速度值。角加速度会被首先转

换为四元数，因为其计算效率高且不会出现万向节锁。线加速度则会被首先用于计算初始

俯仰和横滚角，因为加速度计在静止时能感知重力方向。使用陀螺仪数据计算四元数的变

化率，进行积分得到预测的四元数，之后通过梯度下降使用加速度计数据计算误差，调整

四元数，最后归一化四元数并转为欧拉角输出。

首先设姿态四元数：

q = [qw, qx, qy, qz

] | ||q|| = 1 | (4.1)

陀螺仪测量值为：

ω = [ωx, ωy, ωz | ] | (4.2)

四元数导数为：

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
] | (4.3)

其中⊗为四元数乘法，代入(4.3)展开为矩阵形式得：

dq
dt

=

1
2

[

0 | −ωx
ωx | 0
−ωy | −ωz
ωz | −ωy
ωy | −ωz
ωz | ωy
0 | ωx
−ωx | 0
] q | (4.4)

利用重力方向计算初始姿态角，偏航角初始化为 0：
θ0 = arctan(
ay
√ax
2+az

2

) | (4.5)

φ0 = arctan (

−ax
az
) | (4.6)

利用一阶龙格库塔法对四元数进行离散化积分：

qk+1 = qk +

dq
dt
- Δt | (4.7)

获得以上数据后，需要使用加速度计对角速度进行修正。首先在机体坐标系中表示四

元数所预测的重力向，其中Cb

n为从机体坐标系到导航坐标系的旋转矩阵：

gpred = Cb

n

- [

0

0/1] = [
2(qxqz − qwqy)
2(qwqx + qyqz)
qw

2 − qx

2 − qy

2 + qz

2

] | (4.8)

将实际加速度计测量值归一化，并求取与预测重力方向的误差：

ameas =

[ax,ay,az]

T

||a||

(4.9)

e = ameas × gpred | (4.10)

将误差通过比例积分补偿器或者直接补偿至角速度后，使用修正后的角速度更新四元

数微分方程。最后对四元数进行归一化，并转为欧拉角输出：

q =

q
||q||

||q|| = √qw
2 + qx

2 + qy

2 + qz

2 | (4.11)

{

φ = arctan (

2(qwqx+qyqz)
1−2(qx

2+qy

2)

)

θ = arcsin (2(qwqy − qxqz))

ψ = arctan (

2(qwqz+qxqy)
1−2(qy

2+qz

2
)

)

(4.12)

结算后的欧拉角存储与对外数组中，主任务可以通过数据更新函数获取最新的角度值。

通过实际使用，该角度能够实时可靠地反映装置的当前姿态。

第四章 软件部分
4.2.2 PID 控制算法

在自主控制模式中，需要使用当前的两个自由度的角度值与上位机输入的期望角度值

进行 PID 计算，输出电机控制量使 Pitch 与 Roll 保持在期望位置，且有一定的抗干扰能力。

由于系统主要使用场景为本科生教学，且会开放参数调整，不适宜采用参数较多的算法。

同时系统使用的是空心杯电机，且没有使用编码器等测速装置，对电机的控制属于开环控

制，无电机速度反馈，无法设计更复杂的算法。故每个自由度使用一个 PID 环进行控制，

将期望角度与实际角度输入得到相应输出。

通过前文结构设计可知，Pitch 轴负载为系统整体重量产生的一重力矩，Roll 在静止情

况下无额外负载。同时分析电机与螺旋桨位置，可知作用到 Pitch 自由度的力矩两个电机

输出的力矩相加，而作用到 Roll 自由度的力矩则是两个电机输出力矩的差值。因此，将

Pitch 轴实际角度与期望角度输入一增量式 PID 计算两个电机的输出值；同时将 Roll 轴实

际角度与期望角度输入一位置式 PID 进行计算，其结果相反叠加在增量式 PID 输出结果

上，赋值给定时器输出电机控制 PWM。

位置式一种基于误差绝对值计算控制量的经典算法。其输出直接对应执行机构的绝对

位置，公式由比例项、积分项和微分项的加权和构成：

u(k) = Kpe(k) + Ki ∑ e(j)

k
j=0 | + Kd
[e(k) − e(k − 1)] | (4.13)

针对飞行器控制场景，期望稳态误差为零。该计算过程通过累加历史误差消除稳态误

差，但可能导致积分饱和，需额外设计抗饱和机制。代码中使用积分限幅，通过限制积分

输出最大值的方式防止积分饱和。

增量式 PID 通过计算控制量的变化量更新输出，其公式为位置式的离散差分形式：

Δu(k) = Kp

[e(k) − e(k − 1)] + Ki e(k) + Kd

[e(k) − 2e(k − 1) + e(k − 2)] (4.14)

控制量更新为：

u(k) = u(k − 1) + Δu(k) | (4.15)

增量式 PID 积分项仅依赖当前误差，天然避免积分累积问题。其适用于执行机构需速

度或增量指令的场景，此场景下针对恒力矩载荷的 Pitch 轴，可模拟飞行器高度的定高控

制过程。且此过程无需存储历史误差总和，仅需最近两次误差值，计算量更低。

4.3 控制效果展示

使用系统的 200Hz 姿态数据输出功能，使用 Vofa+串口接收软件进行绘图，可以直观

地展示控制效果。默认两轴期望角度为零度，分别测试系统自稳定与抗干扰能力。图 4.4，

4.5 分别为系统的姿态-时间波形图，图中红色波形为 Pitch 轴角度，绿色波形为 Roll 轴角

度，单位都为度；横轴为时间戳，单位为毫秒。

由于 Pitch 轴恒力矩影响，电机失能时 Pitch 轴有一固定角度，Roll 轴也会随机位于某

一位置。下图描述电机使能后系统运行，将两轴调整至期望角度的过程。由图可看出，由

于 Pitch 轴抗干扰需求，阻尼系数设置的较大，电机输出增加过程较缓慢，从使能到稳定大

约消耗 10s。稳定后效果良好，无超调或稳态误差。

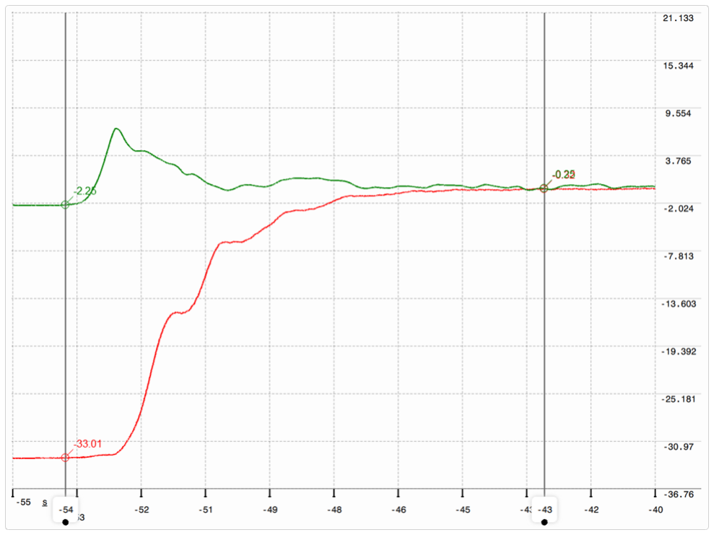
[picture p15: figure]

图 4.4 系统自稳定过程波形图

用手击打主体部分，施加一脉冲扰动。由图可看出，Pitch 轴与 Roll 轴都迅速响应这一

扰动，在阻尼的影响下没有发生超调，且迅速稳定在期望角度。鉴于其负载特性与四旋翼

飞行器类似，此单环 PID 的调整过程效果良好，从受扰动到稳定大约消耗 2s。有效证明了

姿态解算算法与 PID 控制算法的有效性。

第四章 软件部分

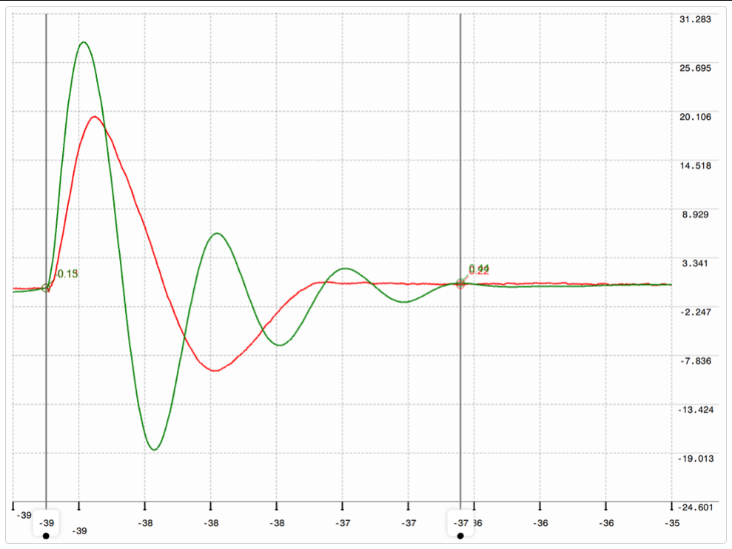
[picture p16: figure]

图 4.5 系统抗冲击干扰波形图

4.4 提升控制效果路径探讨

虽然 PID 控制效果在实验装置上能够满足基本需求，但对于飞行器来说，更加稳定准

确快速的控制效果才能满足现实需求。从简单的 PID 控制到更复杂的高级算法，不仅需要

理论层面的研究，更需要相关实验器材的配套升级。本节会分析目前控制效果的不足，并

提出具体提升控制效果的路径。

四旋翼系统的俯仰、横滚、偏航三轴存在强耦合效应，传统单自由度 PID 难以实现解

耦控制。实验表明，当横滚角偏差超过 15°时，俯仰轴控制误差将增大 37%。对本实验装

置进行分析不难看出，横滚与俯仰的耦合对控制效果影响明显。同时在执行机构上，无刷

电机的死区特性与推力非线性关系会导致控制量映射失真，其典型表现为小推力区域存在

控制盲区，而大推力区呈现饱和现象。仿真数据显示，未补偿时系统超调量增加 21%。而

本设计使用的有刷空心杯电机，在此特点上表现甚至不如无刷电机，直接影响了控制效果。

同时在实际系统特性上，气动阻力、风扰等外部干扰使系统呈现时变特性，传统固定参数

PID 难以维持鲁棒性。在 5m/s 侧风条件下，姿态角稳态误差可达±3°。假定空气阻力不存

在的简化分析并不能满足实际系统的需求。在本设计的调参过程中，两个单环的 PID 整定

过程就比较困难，而实际系统三轴 PID 共需调节 9 个参数，采用试错法耗时且难以达到全

局最优。Ziegler-Nichols 等经验整定方法在四旋翼场景下的适用性不足。

为解决控制效果不好的问题，同时提出使用上位机控制时可参考的方案，针对上述问

题进行解决。

首先，通过实际测试可知，目前传感器的数据实时性与可靠性完全能够满足控制需求，

故工作重点应放在作动器与控制算法。作动器的改进可能会涉及到驱动电路的改进，对其

他耦合模块影响较大，故此处只简略分析控制算法层面可行的路径。而部分控制算法的改

进对作动器有要求，如多级 PID 的应用需要电机能够反馈转速，此类算法的应用需等待硬

件平台支持。下列算法的提出建立在目前的硬件平台上。

针对多参数耦合问题，可使用基于频率响应分析的参数整定方法可系统化解决多参数

耦合问题。频率响应分析通过研究系统在不同频率正弦输入下的稳态响应特性，揭示系统

的动态行为与稳定性特征。由于非线性耦合效应导致传统单自由度 PID 整定方法失效，所

以基于频率响应可以提出以下解耦策略。首先通过动态解耦补偿器构造对角优势传递函数

矩阵，之后固定其他自由度参数，对单自由度进行扫频实验。实验后即可基于 Bode 图确

定各轴独立 PID 参数并引入耦合补偿项进行参数微调。通过此方法可以快速整定 PID 参

数，并能找出参数的最优解。

针对飞行器系统的时变特性，可引入自适应 PID 进行控制。自适应 PID 控制是一种能

够在线调整控制器参数的智能控制方法，其核心目标是通过实时辨识系统动态特性，克服

传统固定参数 PID 在非线性、时变系统中的局限性。主要特征包括根据系统状态或外部环

境变化动态优化参数，跟踪理想参考模型的输出行为与基于 Lyapunov 理论或超稳定性理

论设计自适应律。通过增益调度 PID、模型参考自适应 PID、模糊自适应 PID 等多种形式，

可以显著提升 PID 控制系统的鲁棒性。

由于飞行器的动力学特性可以提前测试，则在各种情况下的载荷一般都可计算，此时

可引入前馈复合控制。前馈-反馈复合控制（Feedforward-Feedback Compound Control）通过

融合前馈控制的预测性与反馈控制的鲁棒性，实现高精度动态跟踪与强抗干扰能力。实际

应用中需考虑模型物理可实现性，高频噪声抑制需求与执行机构饱和限制。前馈-反馈复合

控制通过有机融合两种控制策略的优势，显著提升了动态系统的跟踪精度与抗干扰能力。

在四旋翼飞行控制等快速响应需求场景中，该方案可降低超调量至 5%以下，同时将调节

时间缩短 50%。

针对确定的系统，还可通过前期仿真来确定控制策略。多体动力学仿真通过数学建模

与数值计算，研究由多个刚体或柔性体组成的复杂系统的动力学行为。其核心在于构建拓

扑约束下的运动方程，并求解其随时间演化的动态响应。而此试验台参数实时输出的设计

第四章 软件部分
可支持实时在线仿真。多体动力学仿真与实时接口技术是复杂机电系统开发的核心支撑。

通过模型降阶、实时通信协议与异构计算平台的结合，可实现μs 级精度的硬件在环测试。

本设计可以支持部署多种前沿高级算法，不仅能够作为新算法的开发验证平台，也能

为本科生培训演示新算法与传统算法的控制效果差别，真正做到一机多用。

4.5 本章小结

本章介绍了系统的软件设计思路，并详细阐述部署了 FreeRTOS 的单片机系统内各任

务的执行逻辑，完整说明了系统的运行方式。同时介绍了系统的对外接口与控制逻辑，便

于完善后续产品的使用说明与二次开发。针对系统内使用的姿态解算算法与 PID 控制算法

进行了详细解读，使用数学公式描述了算法的实现过程。使用系统的姿态输出绘制波形图，

直观地展示了系统的自主控制效果。同时结合实际飞行器的控制，阐述在试验平台上部署

高级控制的核心技术与实现路径。

### 第五章 总结与展望

5.1 研究总结

本文着眼于当前本科生自动控制原理实验缺少实用的试验平台这一现象，对试验平台

的需求进行分析，并将需求分解后落实，针对性设计了一款二自由度飞行姿态试验平台。

本文成果如下：

（1） 通过结构硬件与软件的总体设计，制作并调试了样机。在初步测试中确定了该系

统的结构设计方向与软件架构思路。总体方案在测试中表现良好，系统总体性能满足控制

需求。实际测试与上位机的通信效果，姿态输出与接受控制量频率满足要求。使用锂电池

供电与 USB 虚拟串口做到即插即用，充分体现了便携性。

（2） 通过样机的迭代与软件调试，完成了一款拥有二次开发空间与量产可能性的试

验平台设计。结构硬件设计上，完成了建模与原理图绘制和 PCB 制作，并预留了大量产品

级设计，便于后续进行产品化。软件上预留了通信接口，同时编写了大量的注释与文档，

便于后续开发使用。

（3） 针对姿态解算算法与 PID 控制算法进行了数学分析，证明传感器数据的可靠性

与自主控制的可靠性。通过对简化版 AHRS 系统的分析与梳理，阐述了使用单 IMU 角速

度数据积分的方式读取角度，同时借助三轴加速度进行校准的三轴欧拉角获取方式。同时

针对系统结构载荷特性分别使用位置式与增量式 PID，实现优秀的控制效果。

5.2 研究展望

本文提出的设计已制作了样机并验证了基础功能，而要成为产品化的教学用具则还有

大量工作待完成。从功能交付角度，预留的软硬件接口都可进行开发并将其功能最大程度

地完善。从产品化角度，设计的量产性改造与功能性测试还有后续工作要做。

同时，若想使用本系统进行更高级的控制算法开发，需要完成详细的建模工作，包括

系统动力学特性与电机输出特性。此要求可能会对结构设计与动力系统选型提出更高的需

求，同样是日后工作的重点。

### 参考文献

[1] 汤文.二自由度飞行姿态模拟器控制系统设计[D].哈尔滨工业大学,2015.
[2] 尹航,杨烨峰,赵岩,等.二自由度飞行姿态模拟器自整定控制器设计[J].电机与控制学报,2018,22(04):10

5-112.DOI:10.15938/j.emc.2018.04.014.
[3] 孟忱,郝魁红,何永勃.飞机电传操纵及模拟加载系统实验台开发[J].实验技术与管理,2015,32(10):105-1

10.DOI:10.16791/j.cnki.sjg.2015.10.029.
[4] 赵姗姗.二自由度飞机运动模拟台轻小型化技术研究[D].长春理工大学,2014.
[5] 张刘,段广仁,王子华.二自由度飞行姿态模拟器建模及其鲁棒输出调节[J].仪器仪表学报,2006,(S1):47

6-478.DOI:10.19650/j.cnki.cjsi.2006.s1.186.
[6] 赵岩.二自由度直升机模拟器控制系统设计[D].哈尔滨工业大学,2013.
[7] 苏中滨,张磊磊,马铮,等.基于改进 PSO 的无人自转旋翼机二自由度 PID 飞行控制[J].农业机械学报,2

022,53(01):151-158+185.
[8] 鲁兴举.空间飞行器姿态控制仿真试验平台系统研究与设计[D].国防科学技术大学,2005.
[9] 朱红霞,陈磐,李荣.能动专业《自动控制原理》教学改革探索[J].中国电力教育,2022,(09):71-72.DOI:1

0.19429/j.cnki.cn11-3776/g4.2022.09.038.
[10] 吴剑,苗晋玲,代冀阳.三自由度直升机的嵌入式控制系统[J].电子技术应用,2009,35(10):53-57.
[11] 王京锋,樊泽明,杨婷婷.自动控制实验课程混合式教学改革实践[J/OL].实验科学与技术,1-5[2025-05-

12].http://kns.cnki.net/kcms/detail/51.1653.N.20241206.1509.034.html.
[12] 王桂芳,程上方,张瑜.自动控制原理实验教学改革探索[J].实验科学与技术,2020,18(02):98-101.
[13] 熊克勤.三自由度直升机嵌入式控制器设计及其 PID 仿真[D].南昌航空大学,2014.
[14] 王亚刚,许晓鸣,邵惠鹤.基于 Ziegler-Nichols 频率响应方法的自适应 PID 控制[J].控制工程,2012,19(0

4):607-609+613.DOI:10.14107/j.cnki.kzgc.2012.04.036. [15]阳军.自适应控制系统瞬态性能增强及在飞行器姿态控制中的应用[D].昆明理工大学,2020.DOI:10.27

200/d.cnki.gkmlu.2020.000325.

### 学位研究期间取得的主要成果

一、 已发表或已录用的论文

二、 已获专利或软件著作权

三、 曾获相关学科竞赛成绩

（1） 2022 年中国机器人大赛全国一等奖

（2） 2022 年江苏省大学生电子设计竞赛全省一等奖

（3） 2023 年 RoboMaster 机甲大师高校联盟赛（江苏赛区）三等奖

（4） 2023 年 RoboMaster 机甲大师超级对抗赛区域赛（中部分区）二等奖

（5） 2023 年 RoboMaster 机甲大师超级对抗赛全国赛一等奖

四、 曾主持或参加的大学生创新创业训练计划

### 附录 串口通信协议

串口波特率 115200，无流控，无校验位，采用不定长数据包，以帧头帧尾判断数据内

容。

5.3 上位机发送

5.3.1 修改基本运行状态

字节 | 数据 | 备注
[0] | 0x70 | 帧头
[1] | 0x7f | 帧头
[2] | 电机使能状态 | 0：失能 1：使能
[3] | 电机工作模式 | 1：自控 2：外控
[4-7] | 期望 Pitch 角度 | 浮点数 小端序
[8-11] | 期望 Roll 角度 | 浮点数 小端序
[12] 参数实时反馈 | （例 0b00000010：系统基本设置与 PID 参数不 输出，试验台姿态输出） | 小端序： bit[0]：系统基本设置 bit[1]：试验台姿态 bit[2]：PID 参数
[13] | 0x7b | 帧尾
[14] | 0x7f | 帧尾

5.3.2 修改 PID 参数

字节 | 数据 | 备注
[0] | 0x71 | 帧头
[1] | 0x7e | 帧头
[2-5] | KP | 浮点数 小端序
[6-9] | KI | 浮点数 小端序
[10-13] | KD | 浮点数 小端序
[14-17] | 总限幅 MaxOut | 浮点数 小端序
[17-20] | 积分限幅 IMaxOut | 浮点数 小端序
[21] | Pid 模式 | 0：位置式 1：增量式

[22] | 0x7c | 帧尾
[23] | 0x7e | 帧尾

5.3.3 保存修改内容

字节 | 数据 | 备注
[0] | 0x72 | 帧头
[1] | 0x7d | 帧头
[2] | 0x7e | 帧尾
[3] | 0x7d | 帧尾

5.3.4 发送外部控制指令（仅在外部控制模式生效）

字节 | 数据 | 备注
[0] | 0x72 | 帧头
[1] | 0x7d | 帧头
[2] | 左电机 PWM 值低八位 | uint16L
[3] | 左电机 PWM 值高八位 | uint16H
[4] | 右电机 PWM 值低八位 | uint16L
[5] | 右电机 PWM 值高八位 | uint16H
[6] | 0x7e | 帧尾
[7] | 0x7d | 帧尾

5.4 上位机接受

5.4.1 基本运行状态

字节 | 数据 | 备注
[0] | 电机使能状态 | 0：失能 1：使能
[1] | 电机工作模式 | 1：自控 2：外控
[2-5] | 期望 Pitch 角度 | 浮点数 小端序
[6-9] | 期望 Roll 角度 | 浮点数 小端序
[10] 参数实时反馈 | （例 0b00000010：系统基本设置与 PID 参数不 输出，试验台姿态输出） | 小端序： bit[0]：系统基本设置 bit[1]：试验台姿态

| | bit[2]：PID 参数
[11] | 0x00 | 帧尾
[12] | 0x00 | 帧尾
[13] | 0x7e | 帧尾
[14] | 0x81 | 帧尾

5.4.2 PID 参数

字节 | 数据 | 备注
[0-3] | KP | 浮点数 小端序
[4-7] | KI | 浮点数 小端序
[8-11] | KD | 浮点数 小端序
[11-14] | 总限幅 MaxOut | 浮点数 小端序
[15-18] | 积分限幅 IMaxOut | 浮点数 小端序
[19] | Pid 模式 | 0：位置式 1：增量式
[20] | 0x00 | 帧尾
[21] | 0x00 | 帧尾
[22] | 0x7f | 帧尾
[23] | 0x80 | 帧尾

5.4.3 姿态数据

字节 | 数据 | 备注
[0-3] | Pitch 角度 | 浮点数 小端序
[4-7] | Roll 角度 | 浮点数 小端序
[8] | 0x00 | 帧尾
[9] | 0x00 | 帧尾
[10] | 0x80 | 帧尾
[11] | 0x7f | 帧尾

致 谢

时光荏苒，日月如梭，四年校园生活即将结束。至此论文完稿之时，在此对本科求学

期间所有帮助过我的老师、同学们表达感谢。

感谢我的导师黄向华，为我的论文撰写提供了无微不至的帮助。

感谢带我走入科创大门的南航科创中心，让我从一个兴趣浓厚的硬件爱好者第一次接

触到系统的学习路线。虽然原组织没有继续运行下去，但是新的科技中心社团已经成立，

希望科技中心能够继续引领更多热爱科创的人走上工程师之路。

感谢南京航空航天大学长空御风战队，以及战队里与我并肩作战的每一位战友。我永

远记得队内学长对我的悉心教导，永远记得与同级队友共同在比赛场地上的拼搏，永远记

得培训过的新生们逐渐成为独当一面的工程师时的欣慰。我在战队内真正学习到了宝贵的

工程经验，亲自开发调试了自己的机器人，也作为管理者带领了一个 30 人的大团队进行了

一个赛季的热血奋战。希望队伍能够继续培养更多青年工程师走向赛场，初心高于胜负。

感谢战队的叶梁杰、彭施聪、胡成成学长为我走上硬件工程师之路提供的帮助与指导。

感谢本赛季战队机械组组长为本文结构设计提供的技术指导。

感谢我的父母，感谢他们对我的信任与支持，以及二十年来的养育之恩。

最后，向审阅本文的各位专家致敬。
