Tobycsc/2dof-experiment-system/(list of files, drawings)

Other design files:
2dof-experiment-system.eprj
