Tobycsc/2dof-experiment-system/system-MainBoardv2/system-MainBoardv2/system-MainBoardv2.ioc

Mcu.UserName=STM32F407VETx
PA10.Signal=USART1_RX
PA11.Signal=USB_OTG_FS_DM
PA12.Signal=USB_OTG_FS_DP
PA13.Signal=SYS_JTMS-SWDIO
PA14.Signal=SYS_JTCK-SWCLK
PA2.Signal=USART2_TX
PA3.Signal=USART2_RX
PA4.Signal=GPIO_Output
PA5.Signal=SPI1_SCK
PA6.Signal=SPI1_MISO
PA7.Signal=SPI1_MOSI
PA9.Signal=USART1_TX
PB0.Signal=GPIO_Output
PB1.Signal=S_TIM3_CH4
PB10.Signal=I2C2_SCL
PB11.Signal=I2C2_SDA
PB12.Signal=GPIO_Input
PB13.Signal=GPIO_Input
PB14.Signal=GPIO_Input
PB15.Signal=GPIO_Input
PB6.Signal=I2C1_SCL
PB7.Signal=I2C1_SDA
PC0.Signal=GPXTI0
PC3.Signal=ADCx_IN13
PC4.Signal=GPXTI4
PC5.Signal=GPXTI5
PC8.Signal=S_TIM3_CH3
PD8.Signal=GPIO_Input
PE11.Signal=S_TIM1_CH2
PE13.Signal=S_TIM1_CH3
PE2.Signal=GPIO_Output
PE3.Signal=GPIO_Output
PH0-OSC_IN.Signal=RCC_OSC_IN
PH1-OSC_OUT.Signal=RCC_OSC_OUT
