Tobycsc/2dof-experiment-system/system-MainBoard/Core/Inc/main.h

#define LED2_Pin GPIO_PIN_14
#define LED2_GPIO_Port GPIOB
#define LED1_Pin GPIO_PIN_15
#define LED1_GPIO_Port GPIOB
