Tobycsc/2dof-experiment-system/system-MainBoardv2/system-MainBoardv2/bsp/bsp_flash.h

#ifndef BSP_FLASH_H
#define BSP_FLASH_H
#include "struct_typedef.h"





#define FLASH_USER_START_ADDR 0X080E0000
#define FLASH_USER_END_ADDR 0x080FFFFF


#define ADDR_ROLLANGLE_KP 0x080E0000
#define ADDR_ROLLANGLE_KI 0x080E0004
#define ADDR_ROLLANGLE_KD 0x080E0008
#define ADDR_ROLLANGLE_MAX 0x080E000C
#define ADDR_ROLLANGLE_IMAX 0x080E0010
#define ADDR_ROLLANGLE_TYPE 0x080E0014

#define ADDR_ROLLSPEED_KP 0x080E0016
#define ADDR_ROLLSPEED_KI 0x080E001A
#define ADDR_ROLLSPEED_KD 0x080E001E
#define ADDR_ROLLSPEED_MAX 0x080E0022
#define ADDR_ROLLSPEED_IMAX 0x080E0026
#define ADDR_ROLLSPEED_TYPE 0x080E002A

#define ADDR_PITCHANGLE_KP 0x080E002C
#define ADDR_PITCHANGLE_KI 0x080E0030
#define ADDR_PITCHANGLE_KD 0x080E0034
#define ADDR_PITCHANGLE_MAX 0x080E0038
#define ADDR_PITCHANGLE_IMAX 0x080E003C
#define ADDR_PITCHANGLE_TYPE 0x080E0040

#define ADDR_PITCHSPEED_KP 0x080E0042
#define ADDR_PITCHSPEED_KI 0x080E0046
#define ADDR_PITCHSPEED_KD 0x080E004A
#define ADDR_PITCHSPEED_MAX 0x080E004E
#define ADDR_PITCHSPEED_IMAX 0x080E0052
#define ADDR_PITCHSPEED_TYPE 0x080E0056

#define ADDR_MODE_FLAG 0x080E0058
#define ADDR_UARTTRAN_FLAG 0x080E005A



void ReadAllPara(void);
uint8_t WriteAllPara(void);



extern float u8Arry2float(uint8_t *data);
extern void float2u8Arry(uint8_t *u8Arry, float *floatdata);
extern int32_t u8Arry2int32(uint8_t* data);

#endif
