Tobycsc/2dof-experiment-system/system-MainBoardv2/system-MainBoardv2/application/protocol.h

/**
  ******************************************************************************
  * @file    protocol.h
  * @author  Karolance Future
  * @version V1.3.0
  * @date    2022/03/21
  * @brief   依据裁判系统 串口协议附录 V1.3
  ******************************************************************************
  * @attention
	*
  ******************************************************************************
  */

#ifndef ROBOMASTER_PROTOCOL_H
#define ROBOMASTER_PROTOCOL_H

#include "stdint.h"

#define HEADER_SOF                  0xA5

#define REF_PROTOCOL_FRAME_MAX_SIZE 128
#define REF_PROTOCOL_HEADER_SIZE    sizeof(frame_header_struct_t)
#define REF_PROTOCOL_CMD_SIZE       2
#define REF_PROTOCOL_CRC16_SIZE     2

#define REF_HEADER_CRC_LEN          (REF_PROTOCOL_HEADER_SIZE + REF_PROTOCOL_CRC16_SIZE)
#define REF_HEADER_CRC_CMDID_LEN    (REF_PROTOCOL_HEADER_SIZE + REF_PROTOCOL_CRC16_SIZE + sizeof(uint16_t))
#define REF_HEADER_CMDID_LEN        (REF_PROTOCOL_HEADER_SIZE + sizeof(uint16_t))

#pragma pack(push, 1)

typedef enum
{
	GAME_STATE_CMD_ID                 = 0x0001,  //比赛状态数据
	GAME_RESULT_CMD_ID                = 0x0002,  //比赛结果数据
	GAME_ROBOT_HP_CMD_ID              = 0x0003,  //机器人血量数据
	DART_FLYING_STATE_CMD_ID          = 0x0004,  //飞镖发射后状态
	
	FIELD_EVENTS_CMD_ID               = 0x0101,  //场地事件数据
	SUPPLY_PROJECTILE_ACTION_CMD_ID   = 0x0102,  //补给站动作标识
	SUPPLY_PROJECTILE_BOOKING_CMD_ID  = 0x0103,  //请求补给站补弹数据，由参赛队发送（RM 对抗赛尚未开放）
	REFEREE_WARNING_CMD_ID            = 0x0104,  //裁判警告信息
	DART_REMAINING_TIME_CMD_ID        = 0x0105,  //飞镖发射口倒计时
	
	ROBOT_STATE_CMD_ID                = 0x0201,  //比赛机器人状态
	POWER_HEAT_DATA_CMD_ID            = 0x0202,  //实时功率热量数据
	ROBOT_POS_CMD_ID                  = 0x0203,  //机器人位置
	BUFF_MUSK_CMD_ID                  = 0x0204,  //机器人增益
	AERIAL_ROBOT_ENERGY_CMD_ID        = 0x0205,  //空中机器人能量状态
	ROBOT_HURT_CMD_ID                 = 0x0206,  //伤害状态
	SHOOT_DATA_CMD_ID                 = 0x0207,  //实时射击信息
	BULLET_REMAINING_CMD_ID           = 0x0208,  //子弹剩余发射数
	ROBOT_RFID_STATE_CMD_ID           = 0x0209,  //机器人RFID状态
	DART_CLIENT_CMD_ID                = 0x020A,  //飞镖机器人客户端指令数据
	
	STUDENT_INTERACTIVE_DATA_CMD_ID   = 0x0301,  //机器人间通信
  ROBOT_COMMAND_CMD_ID              = 0x0303,  //小地图下发信息标识
  CLIENT_MAP_COMMAND_CMD_ID         = 0x0305,  //小地图接收信息标识
	IDCustomData,
}referee_cmd_id_e;

typedef enum
{
  STEP_HEADER_SOF  = 0,
  STEP_LENGTH_LOW  = 1,
  STEP_LENGTH_HIGH = 2,
  STEP_FRAME_SEQ   = 3,
  STEP_HEADER_CRC8 = 4,
  STEP_DATA_CRC16  = 5,
} unpack_step_e;

typedef struct __attribute__((packed))
{
  uint8_t  SOF;
  uint16_t data_length;
  uint8_t  seq;
  uint8_t  CRC8;
} frame_header_struct_t;

typedef struct __attribute__((packed))
{
  frame_header_struct_t *p_header;
  uint16_t       data_len;
  uint8_t        protocol_packet[REF_PROTOCOL_FRAME_MAX_SIZE];
  unpack_step_e  unpack_step;
  uint16_t       index;
} unpack_data_t;

#pragma pack(pop)

#endif //ROBOMASTER_PROTOCOL_H
