Tobycsc/2dof-experiment-system/system-MainBoardv2/system-MainBoardv2/bsp/bsp_fric.h

#ifndef BSP_FRIC_H
#define BSP_FRIC_H
#include "struct_typedef.h"

#define FRIC_UP 1500
#define FRIC_DOWN 1465
#define FRIC_OFF 1000

extern void fric_off(void);
extern void fric1_on(uint16_t cmd);
extern void fric2_on(uint16_t cmd);
#endif
