Tobycsc/2dof-experiment-system/system-MainBoardv2 - test/system-MainBoardv2/application/Gimbal_Task.h

#ifndef _GIMBAL_TASK
#define _GIMBAL_TASK

#include "struct_typedef.h"
#include "pid.h"




#define YAW_MOTOR_SPEED_PID_KP 8000.0f
#define YAW_MOTOR_SPEED_PID_KI 75.0f
#define YAW_MOTOR_SPEED_PID_KD 0.0f
#define YAW_MOTOR_SPEED_PID_MAX_OUT 25000.0f
#define YAW_MOTOR_SPEED_PID_MAX_IOUT 1300.0f

#define YAW_MOTOR_ANGLE_PID_KP 0.2f
#define YAW_MOTOR_ANGLE_PID_KI 0.0f
#define YAW_MOTOR_ANGLE_PID_KD 0.0f
#define YAW_MOTOR_ANGLE_PID_MAX_OUT 6.0f
#define YAW_MOTOR_ANGLE_PID_MAX_IOUT 100.0f


#define YAW_MOTOR_AUTO_AIM_PID_KP 0.1f//0.2f
#define YAW_MOTOR_AUTO_AIM_PID_KI 0.0003f//0.001f
#define YAW_MOTOR_AUTO_AIM_PID_KD 0.0f
#define YAW_MOTOR_AUTO_AIM_PID_MAX_OUT 6.0f
#define YAW_MOTOR_AUTO_AIM_PID_MAX_IOUT 1000.0f

#define PITCH_MOTOR_SPEED_PID_KP 9700.0f
#define PITCH_MOTOR_SPEED_PID_KI 100.0f
#define PITCH_MOTOR_SPEED_PID_KD 0.0f
#define PITCH_MOTOR_SPEED_PID_MAX_OUT 25000.0f
#define PITCH_MOTOR_SPEED_PID_MAX_IOUT 7000.0f

#define PITCH_MOTOR_ANGLE_PID_KP 0.2f//0.2f
#define PITCH_MOTOR_ANGLE_PID_KI 0.0f
#define PITCH_MOTOR_ANGLE_PID_KD 0.0f//3.0f
#define PITCH_MOTOR_ANGLE_PID_MAX_OUT 3.0f
#define PITCH_MOTOR_ANGLE_PID_MAX_IOUT 10.0f


#define PITCH_MOTOR_AUTO_AIM_PID_KP 0.2f
#define PITCH_MOTOR_AUTO_AIM_PID_KI 0.0f//0.0005f
#define PITCH_MOTOR_AUTO_AIM_PID_KD 0.0f
#define PITCH_MOTOR_AUTO_AIM_PID_MAX_OUT 3.0f
#define PITCH_MOTOR_AUTO_AIM_PID_MAX_IOUT 100.0f

#define CHASSIS_FOLLOW_GIMBAL_ANGLE_ZERO 5783




void Gimbal_Task(void const * argument);

#endif
