Tobycsc/2dof-experiment-system/(commit log)

2025-01-15 功能验证完成
    [2dof-experiment-system.eprj]
2025-02-03 feat: 测试imu与电机控制
    没加续流二极管
    下一版imu改为bmi088
    5v母线供电二极管
    TP5400GND
2025-03-18 feat:绘制v2pcb
    [2dof-experiment-system.eprj]
2025-03-18 feat:生成新版代码
    [2dof-experiment-system.eprj]
2025-04-10 feat:实现BMI088读取
2025-04-26 feat:完成基本功能代码编写
2025-05-01 feat:完成基本功能初步调参
    更新V0.2正式板
    [2dof-experiment-system.eprj]
2025-05-01 feat:完成基本功能稳定调参、增加温度电压传感
2025-05-01 feat:完成基本功能稳定调参、增加充电状态传感、LED显示、控制频率500hz
2025-05-05 feat:增加USB虚拟串口发送姿态
2025-05-11 feat:增加论文文档
    [2dof-experiment-system.eprj, BOM_v2_Schematic2_2025-03-18.xlsx]
2025-06-11 feat：新板子
    [BOM_v2_Schematic2_2025-03-18.xlsx]
2025-06-13 feat：实现flash烧写
2025-06-14 feat：实现串口通信
2025-06-14 feat：增加串口调试脚本
2025-06-14 fix：更新测试脚本
2025-06-15 feat：更新readme
2025-06-15 feat：增加论文
