Tobycsc/2dof-experiment-system/(notices)

Notices in the files:
system-MainBoardv2/system-MainBoardv2/Core/Src/main.c:
Copyright (c) 2025 STMicroelectronics.
All rights reserved.
This software is licensed under terms that can be found in the LICENSE file
